clatoverada/wvc700r3-life-better-mppt/wiki/schematic1.jpg

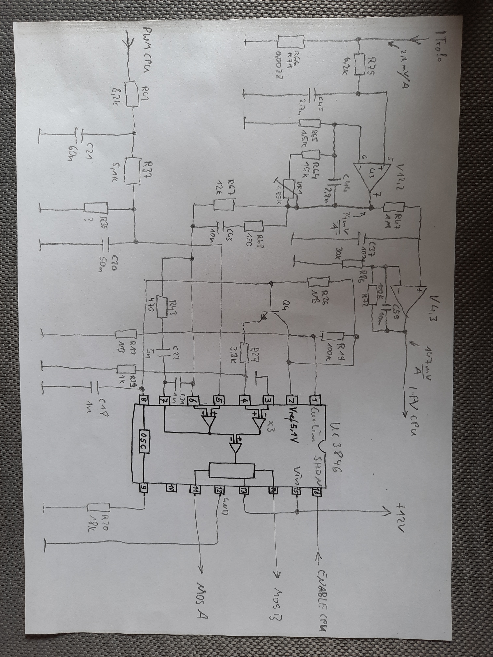
wiki/schematic1.jpg
