clatoverada/wvc700r3-life-better-mppt/wiki/schematic2.png

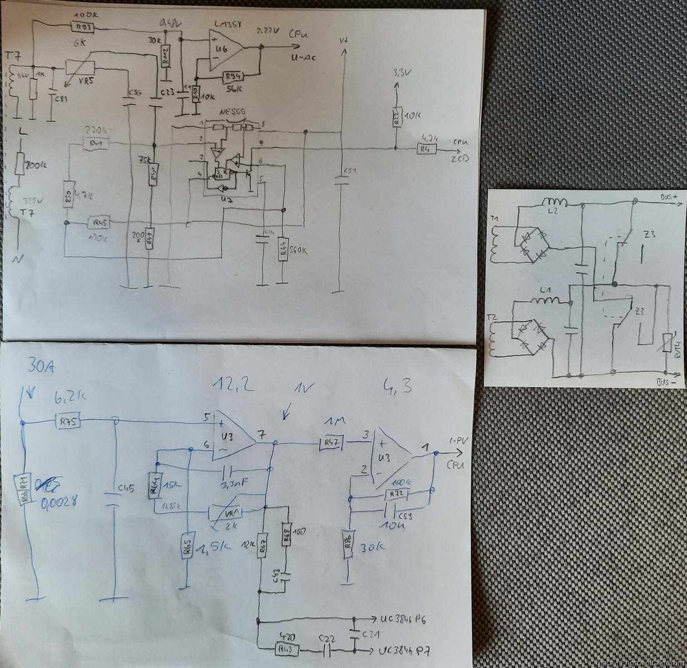
wiki/schematic2.png
