clatoverada/wvc700r3-life-better-mppt/wiki/wvc700-move-r42.png

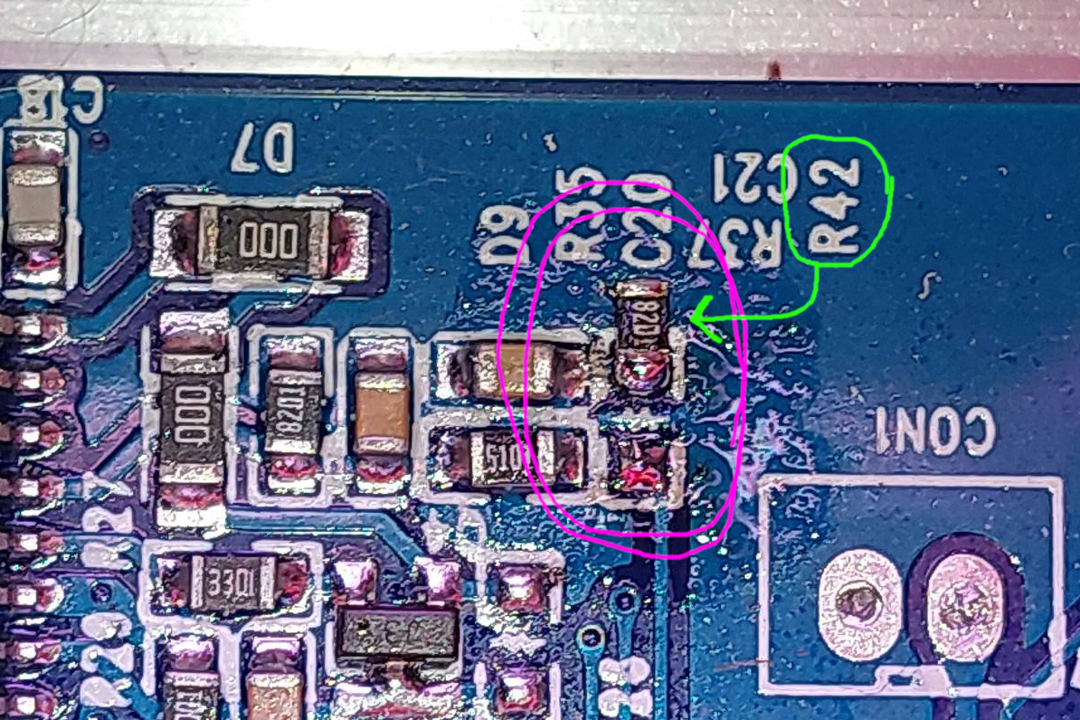
wiki/wvc700-move-r42.png
