clatoverada/wvc700r3-life-better-mppt/wiki/wvc700-removed-L1-(1).png

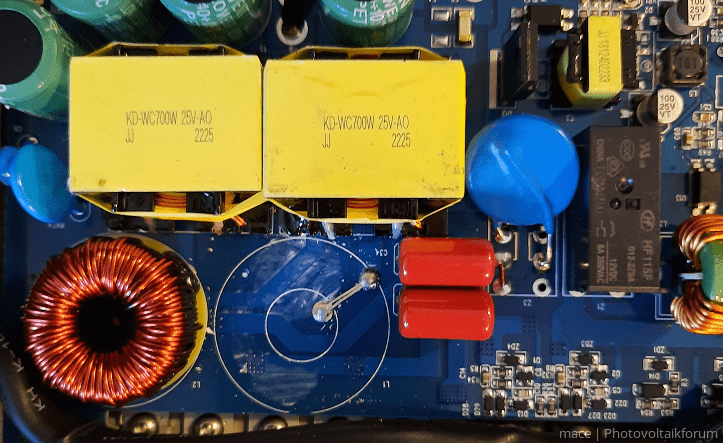
wiki/wvc700-removed-L1-(1).png
