clatoverada/wvc700r3-life-better-mppt/wiki/wvc700-wires-attiny85(1).png

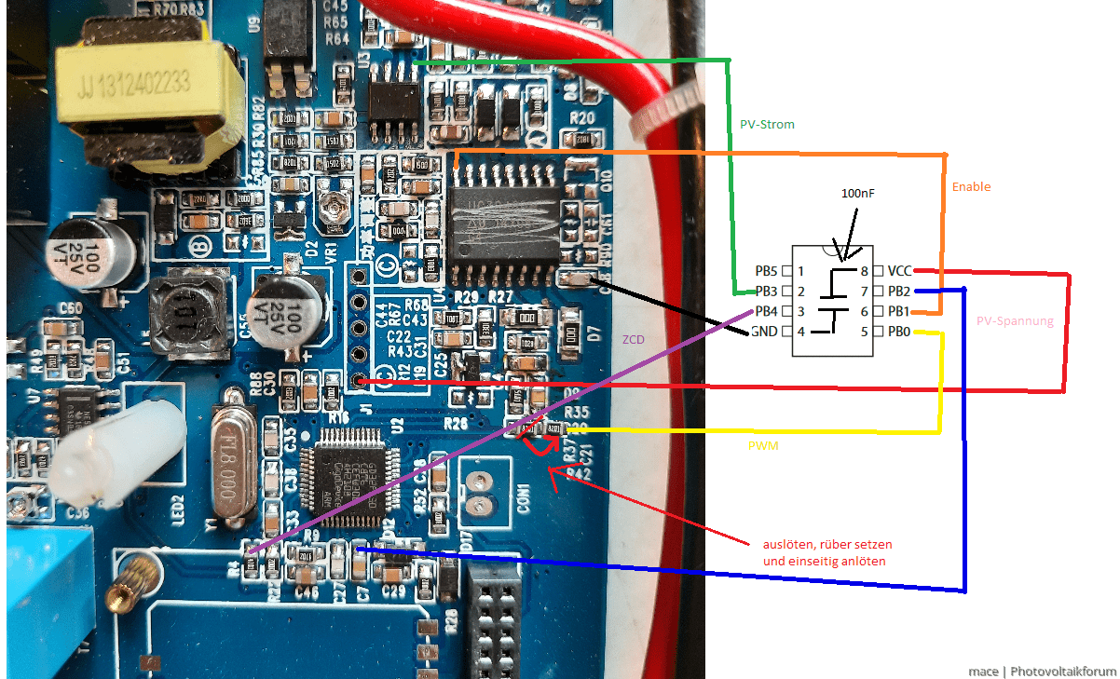
wiki/wvc700-wires-attiny85(1).png
