clatoverada/wvc700r3-life-better-mppt/wiki/WVC700R3-B2-top.jpg

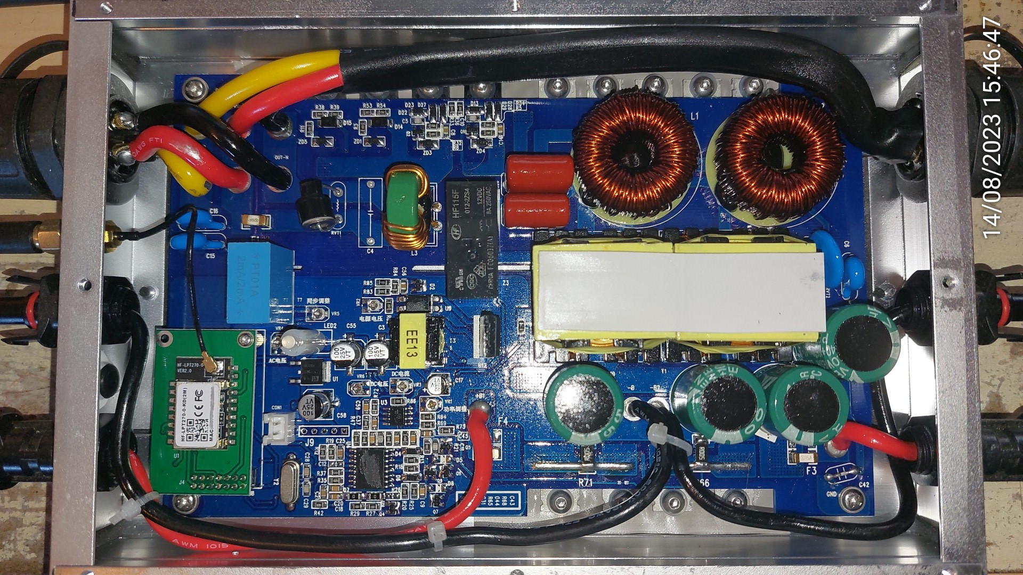
wiki/WVC700R3-B2-top.jpg
