clatoverada/wvc700r3-life-better-mppt/wiki/WVC700R3-B3-bottom.jpg

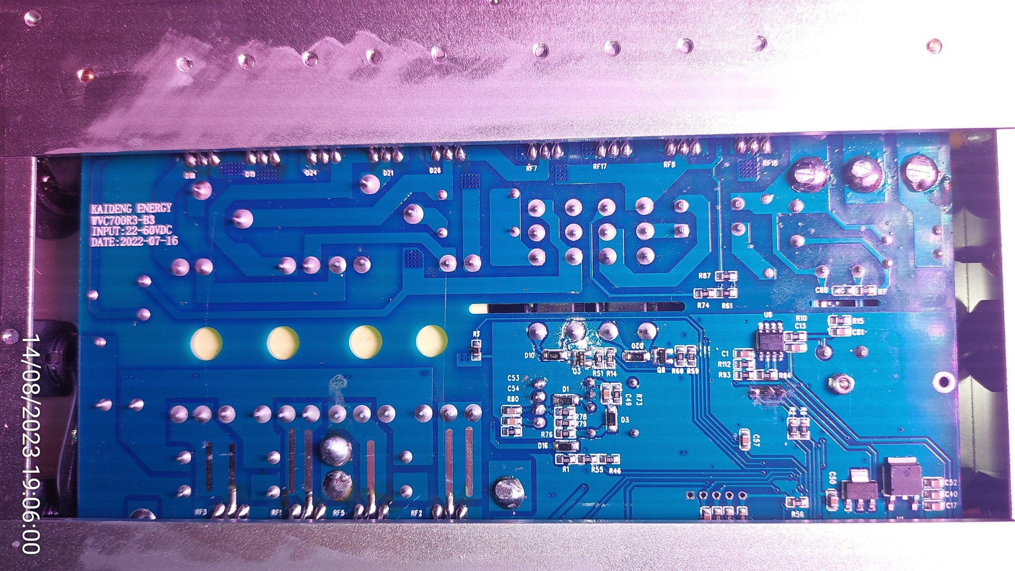
wiki/WVC700R3-B3-bottom.jpg
