clatoverada/wvc700r3-life-better-mppt/wvc-700-tiny85.ino

#include <avr/io.h>
#include <stdbool.h>
#include <avr/interrupt.h>
#include <stdint.h>

#define Mittel_aus 16 //gleitendens Mittel aus X Werten (Maximal 63 sonst Überlauf)

//LUT mit modifiziertem Sinus mit größeren Pausen in den Nulldurchgängen und etwas phasenverschoben
const uint8_t sinus2[] ={0,0,0,0,5,12,19,26,33,40,47,55,62,69,75,82,89,95,102,108,114,121,127,133,
	139,145,151,155,161,166,172,177,181,186,191,196,199,204,208,212,216,219,223,
	227,229,232,235,237,240,242,244,246,248,249,250,251,253,254,254,255,255,255,
	255,255,254,254,253,251,250,249,248,246,244,242,240,237,235,232,229,227,223,
	219,216,212,208,204,199,196,191,186,181,177,172,166,161,155,151,145,139,133,
	127,121,114,108,102,95,89,82,75,69,62,55,47,40,33,26,19,12,5,0,0,0,0,0,0,0,0,0,0,
	0,0,0};
//LUT mit standard Sinus
const uint8_t sinus1[] = {0,6,13,19,25,31,37,44,50,56,62,68,74,80,86,92,98,103,109,115,120,126,131,136,
	142,147,152,157,162,167,171,176,180,185,189,193,197,201,205,208,212,215,219,
	222,225,228,231,233,236,238,240,242,244,246,247,249,250,251,252,253,254,254,
	255,255,255,255,255,254,254,253,252,251,250,249,247,246,244,242,240,238,236,
	233,231,228,225,222,219,215,212,208,205,201,197,193,189,185,180,176,171,167,
	162,157,152,147,142,136,131,126,120,115,109,103,98,92,86,80,74,68,62,56,50,
	44,37,31,25,19,13,6,
	0,0,0};

const uint16_t minimalspannung_abs = 410 * Mittel_aus;  //= etwa 26V darunter kann der Wandler wegen zu geringer Ausgangsspannung an den Scheitelpunkten nicht ins Netz einspeisen
const uint16_t maximalstrom_abs = 700 * Mittel_aus / 6; //= etwa 15A darüber wird der WR wohl verglühen

volatile uint16_t Synccounter=0, abregelwert=0, cnt100ms=0;
volatile uint8_t U_out=0, counter=0;
volatile bool flag100ms=0, Sync=0;

void ADC_Init();
uint16_t ADC_Read(uint8_t channel);

int main(void) {
	uint8_t Schritt=1,cnt_a=0, startverz=0;
	bool enable,teilbereichsuche=false;
	uint16_t spannung_MPP=0, Langzeitzaehler=0,minimalspannung=0,maximalspannung=0,maximalstrom=0;
	uint32_t leistung_MPP=0;
	uint16_t spannung=0, strom=0, spannung_a[Mittel_aus], strom_a[Mittel_aus], temperatur=0;
	uint32_t leistung;

	DDRB = 0b00000001;    //PB0 als PWM Ausgang
	TCCR0A = 0b10000011;  //Timer0 für PWM Ausgabe einstellen
	TCCR0B = 0b00000001;
	TCCR1 = 0b10000100;  //Timer1 auf einen Zyklus einstellen
	OCR1C = 156;         //um mit den Werten aus der Sinus-LUT
	OCR1A = 0;           //Sinushalbwellen mit 50Hz auszugeben
	TIMSK = 0b01000000;  //Freigabe Interupt Timer1
	GIMSK = 0b00100000;  //Freigabe Pin Change Interrupt
	PCMSK = 0b00010000;  //auf PortB 4 für ZCD
	ADC_Init();
	for (cnt_a=0;cnt_a < Mittel_aus;cnt_a++)
	{
		spannung_a[cnt_a]=0;
		strom_a[cnt_a]=0;
	}
	cnt_a=0;
	sei();
	
	while (1) {

		//sobald die Reglerfreigabe weg geht oder die Netzsyncronität verloren geht Wandler Stom abschalten und in den Warteschritt gehen
		enable = (PINB & (1 << PINB1)) == 0;
		if (!enable || !Sync) {
			Schritt = 1;
			U_out = 0;
		}
		//wenn nix los dann messen und gleitendes Mittel aus "Mittel_aus" Werten bilden, aktuelle Leistung ausrechnen und im Suchmodus die Maximalwerte speichern
		if (flag100ms==false) {
			if (cnt_a > Mittel_aus-1) cnt_a=0;
			spannung-=spannung_a[cnt_a];
			spannung_a[cnt_a]= ADC_Read(1);//1V=0,05V am ADC 3,3v=66v
			spannung+=spannung_a[cnt_a];
			strom-=strom_a[cnt_a];
			strom_a[cnt_a] = ADC_Read(3);//1A=0,14V am ADC 3,3v=23,6a
			strom+=strom_a[cnt_a];
			cnt_a++;
			if (Schritt==2){ //im Suchschritt suchen wir hier den Punkt mit der grösten Leistung und merken uns die Spannung dort. Auf die regeln wir später.
				leistung = (uint32_t) spannung * strom;
				if (leistung > leistung_MPP) {
					spannung_MPP = spannung; 
					leistung_MPP = leistung;
				}
			}
		}
		//Haupttakt alle 100ms
		else{
			flag100ms = false;
			ADMUX=0b10001111;		//ADC auf 1,1V Referenz und Temperatursensor stellen
			temperatur=ADC_Read(15); //Temperatur im Gehäuse messen
			ADMUX=0b00000001;		//ADC auf Vcc (3,3v) Referenz und PB2 stellen
			maximalstrom = maximalstrom_abs * (6 - abregelwert); //aktuellen Maximalstrom aus maximalem Wechselrichterstrom und dem Abregelwert berechnen
			switch (Schritt) {
				case 1: //Warteschritt
				//auf die Reglerfreigabe vom Hauptcontroller und Netzsyncronität warten
				{
					if (enable && Sync) {
						if(startverz<50) //wenn startklar noch 5 Sekunden warten
							startverz++;
						else{
							minimalspannung=minimalspannung_abs;
							maximalspannung=minimalspannung_abs;
							Langzeitzaehler = 0;
							leistung_MPP = 0;
							U_out = 0;
							Schritt = 2;
							startverz=0;
						}
					}
					else
						startverz=0;
					break;
				}
				case 2: //MPP finden Schritt
				//Wandlerstom kontinuirlich hoch fahren bis die Zellspannung auf die Minimalspannung sinkt oder der Strom auf den Maximalstrom steigt
				//dabei den Punkt mit der grösten Leistung suchen und sich die Spannung dort merken = MPP Spannung
				{
					if (maximalspannung < spannung) maximalspannung = spannung;
					if(teilbereichsuche){
						if((maximalspannung - (maximalspannung >> 2)) > minimalspannung) minimalspannung = (maximalspannung - (maximalspannung >> 2));
					}
					else minimalspannung = minimalspannung_abs;
					
					if ((spannung > minimalspannung) && (strom < maximalstrom)) {
						if (U_out < 255) {
							U_out++;
						}
						else {
							teilbereichsuche = false;
							Schritt = 3;
						}
					}
					else {
						teilbereichsuche = false;
						Schritt = 3;
					}
					break;
				}
				case 3: //Regelbetrieb Schritt
				{
					//bei plötzlicher Verschattung leistung schnell reduzieren (Spannung fällt unter 24V)
					if (spannung < (minimalspannung_abs - 38 * Mittel_aus)) {
						U_out = U_out >> 1;
					}
					//ansonsten Wandlerstrom kontinuirlich so einstellen dass die Zellen mit der in Schritt 2 gefundenen MPP Spannung laufen
					else {
						if ((spannung < spannung_MPP)||(strom > maximalstrom) || (temperatur > 355)) { //72°C
							if (U_out > 0) U_out--; //Ausgangsstrom reduzieren
						}
						if ((spannung > spannung_MPP) && (strom < maximalstrom) && (temperatur < 350)) { //68°C
							if (U_out < 255) U_out++; //Augangsstrom erhöhen
						}
					}
					Langzeitzaehler++;
					//alle 10 min gucken ob sich die MPP Spannung durch änderung der Zellentemperatur verschoben hat
					//Wandlerstom dazu um 1/4 senken und Suche starten
					if ((Langzeitzaehler == 6000) || (Langzeitzaehler == 12000)) {
						leistung_MPP = 0;
						U_out -= U_out >> 2;
						teilbereichsuche=true;
						Schritt = 2;
					}
					//alle 30min gucken ob sich durch verschattung ein neues globales maximum gebildet hat
					//Wandlerstom dazu auf 1/8 absenken und Suche starten
					if (Langzeitzaehler == 18000) {
						leistung_MPP = 0;
						Langzeitzaehler = 0;
						U_out = U_out >> 3;
						Schritt = 2;
					}
					break;
				}
			}
		}
	}
}

//Sinushalbwellen mit variabler Amplitude für den Strommodulator und den 200ms Takt für die Hauptschleife erzeugen
ISR(TIMER1_COMPA_vect) {
	OCR0A = (sinus2[(uint8_t)Synccounter&0b01111111] * (uint16_t)U_out) >> 8;
	if (cnt100ms < 1282) {
		cnt100ms++;
	}
	else {					//alle 1282 x 78us = 100ms (16MHz/8/156=78us)
		cnt100ms = 0;		//das Flag für die Hauptschleife setzen
		flag100ms = true;
	}
	Synccounter++;
	if (Synccounter > 258)
	{
		Sync=0;
	}
}



//auf Netzfrequenz und Phase synchronisieren

ISR(PCINT0_vect) { //ZCD Interupt bei 50Hz alle 20ms
	if ((PINB & (1 << PINB4))) {
		if (Synccounter < 256) OCR1C--; //Timer 1 so nachführen dass er netzsyncron läuft
		if (Synccounter > 256) OCR1C++; //müsste bei 50Hz bei OCR1C=156 sein
		if (Synccounter == 256) Sync = 1; 
		if ((OCR1C < 150) || (OCR1C > 160)) Sync = 0; //Netzfrequenz überwachen Grenze 52,06Hz und 48,82Hz
		if ((OCR1C >= 150) && (OCR1C <= 156)) abregelwert = 156 - OCR1C; //Zwischen 50 und 52Hz Leistung abregeln
		Synccounter = 0;
	}
}

void ADC_Init(void) {
	// die Versorgungsspannung AVcc als Referenz wählen:
	ADMUX = 0;
	// oder interne Referenzspannung als Referenz für den ADC wählen:
	// ADMUX = (1<<REFS1) | (1<<REFS0);
	// Bit ADFR ("free running") in ADCSRA steht beim Einschalten
	// schon auf 0, also single conversion
	ADCSRA = (1 << ADPS2) | (1 << ADPS1);  // Frequenzvorteiler
	ADCSRA |= (1 << ADEN);                 // ADC aktivieren
	DIDR0 = 0b00001100;
	/* nach Aktivieren des ADC wird ein "Dummy-Readout" empfohlen, man liest
	also einen Wert und verwirft diesen, um den ADC "warmlaufen zu lassen" */
	ADCSRA |= (1 << ADSC);          // eine ADC-Wandlung
	while (ADCSRA & (1 << ADSC)) {  // auf Abschluss der Konvertierung warten
	}
	/* ADCW muss einmal gelesen werden, sonst wird Ergebnis der nächsten
	Wandlung nicht übernommen. */
	(void)ADCW;
}

/* ADC Einzelmessung */
uint16_t ADC_Read(uint8_t channel) {
	// Kanal waehlen, ohne andere Bits zu beeinflußen
	ADMUX = (ADMUX & ~(0x1F)) | (channel & 0x1F);
	ADCSRA |= (1 << ADSC);          // eine Wandlung "single conversion"
	while (ADCSRA & (1 << ADSC)) {  // auf Abschluss der Konvertierung warten
	}
	return ADCW;  // ADC auslesen und zurückgeben
}
