clatoverada/wvc700r3-life-better-mppt/(commit log)

2023-08-05 Create wvc-700-tiny85.ino
    Initial commit from photovoltaik forum:
    https://www.photovoltaikforum.com/thread/209046-wvc700r3-mppt-regler-tauschen/
2023-08-20 Update README.md
    DangerDevil: "der 100nF Stützkondensator fehlt in der Materialliste"
2023-08-20 Update wvc-700-tiny85.ino
    The most important change is that the MPP search no longer calculates with the measured current but with the reference value that the controller sets for the DC/DC converter.
    As long as the input voltage is large enough and can be fed in sine-wave, this is directly proportional to the current. In opposite to the current, however, it is not affected by any interferences.
    Further, the scaling and the offset of the measured values have been dropped. On closer inspection, this turned out to be mathematically useless and only costs processing time.
    [wvc-700-tiny85.ino]
2023-08-26 Update wvc-700-tiny85.ino
    Changes:
    - introduced a moving average for measurements of U-PV and I-PV. The depth can be configured by "Mittel_aus"
    - Power will be calculated again with measured current instead U_Out.
    - removed the SEI and CLI instructions from the ISR because this is done by hardware anyway
    - set the time step of the main loop to 200ms again
2024-08-28 Update wvc-700-tiny85.ino
    Modified Grid synchronisation procedure and added a check that the grid frequency is in the range of 50Hz. Inverter will stop if sync or frequency runs out of spec.
2024-09-24 Update wvc-700-tiny85.ino
    -Fehler vom letzten Commit beseitigt
    -Eine Funktion zum abregeln der der Einspeiseleistung bei ansteigen der Netzfrequenz hinzugefügt.
2024-11-18 add inverter schematics and documentation for WLAN-Module
